17amm98/openflight/cad/IARC_case/README.md

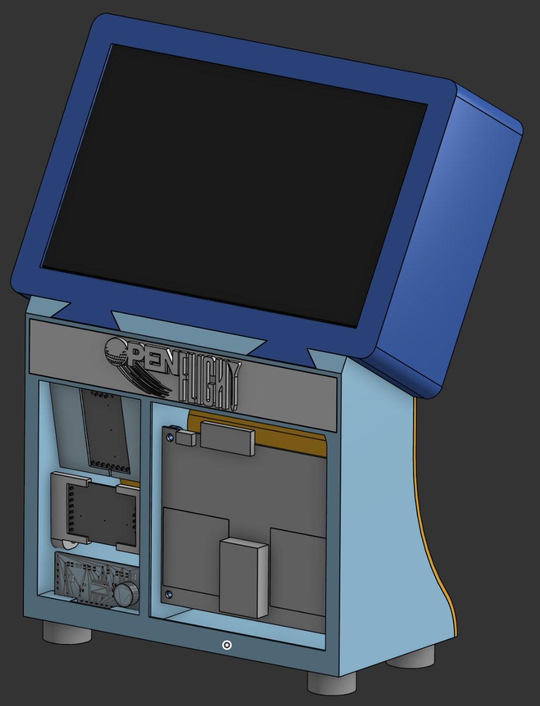
[picture p1: cad/IARC_case/images/IARC_case_v3.png]


- M5 Bolts needed: 10
- M2.5 Bolts needed: 12

Instructions for OpenFlight IARC v3 Case Build
  
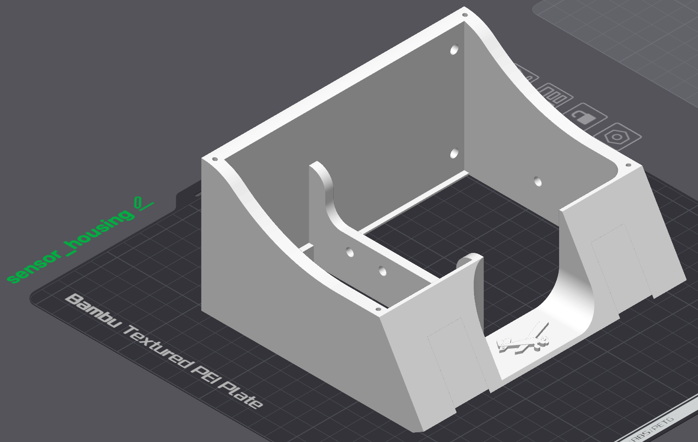
[picture p2: cad/IARC_case/images/sensor_housing.png]
1. Print out `sensor_housing.stl` 
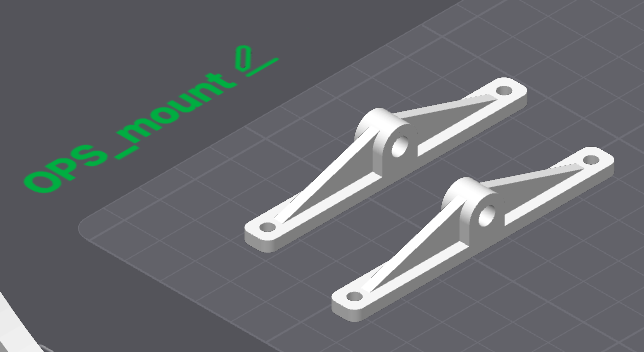
[picture p3: cad/IARC_case/images/ops_mount.png]
2. Print out (2x) `OPS_mount.stl` 
3. Secure the OPS sensor to each `OPS_mount.stl` part with screws (I don't know which ones)
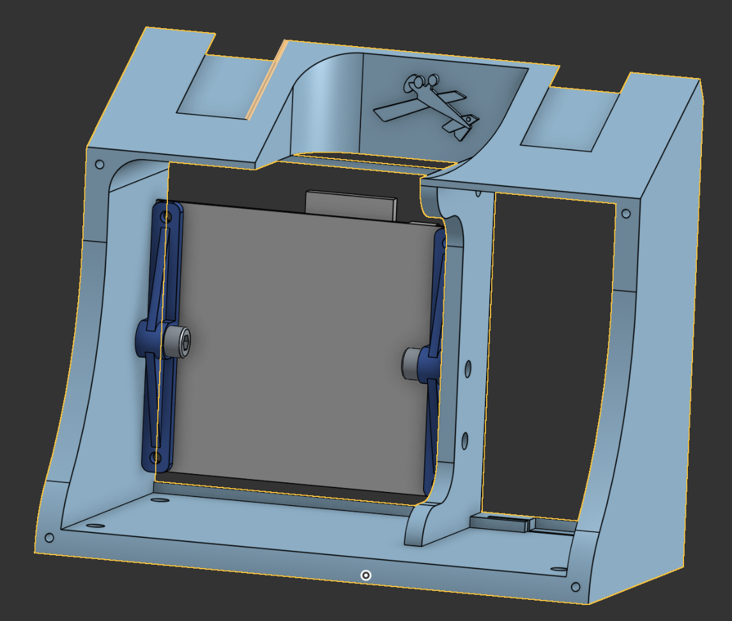
[picture p4: cad/IARC_case/images/secure_ops_mount.png]
4. Secure the `OPS_mount.stl` parts to the `sensor_housing.stl` part with (2x) M5 bolt 
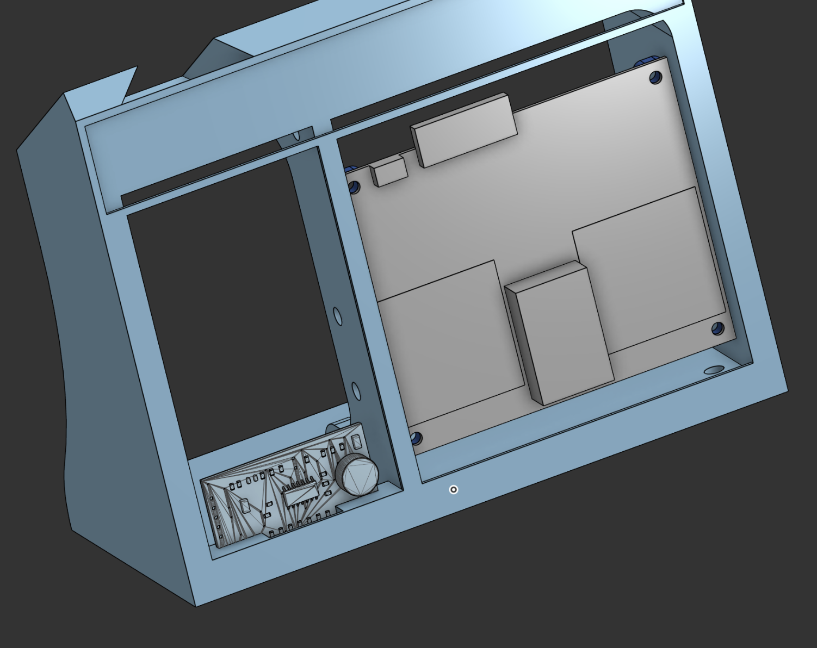
[picture p5: cad/IARC_case/images/sound_placement.png]
5. Fit the sound sensor into the little slot on the left side of the `sensor_housing.stl` part. 
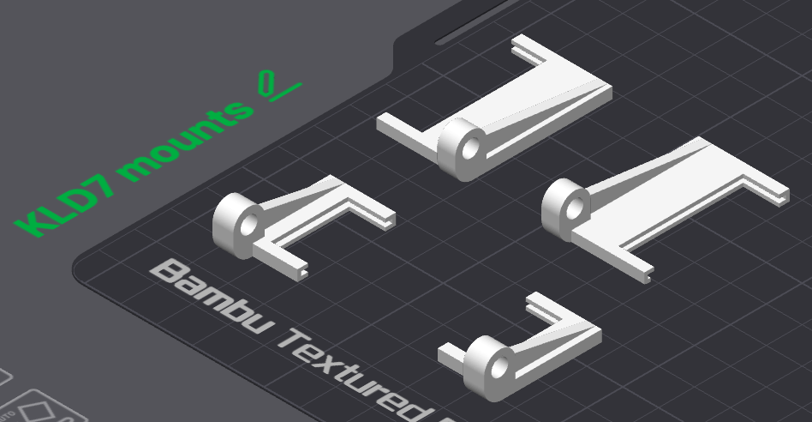
[picture p6: cad/IARC_case/images/KLD7_mounts.png]
6. Print out (1x) `KLD7_h_mount_L_v2.stl` and (1x) `KLD7_h_mount_R_v2.stl` 
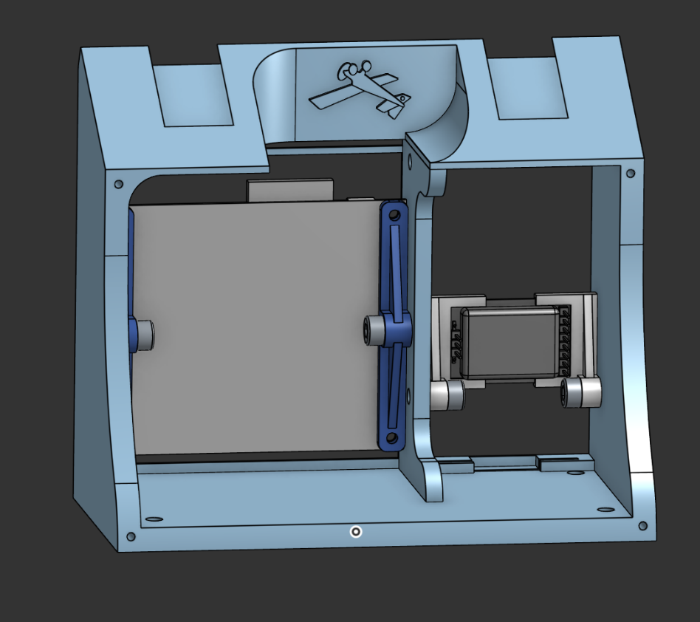
[picture p7: cad/IARC_case/images/bottom_KLD7_mount.png]
7. Slot a KLD7 sensor between the mount parts, and secure them to the `sensor_housing.stl` part with (2x) M5 bolt 
8. Print out (1x) `KLD7_v_mount_L_v2.stl` and (1x) `KLD7_v_mount_R_v2.stl` 
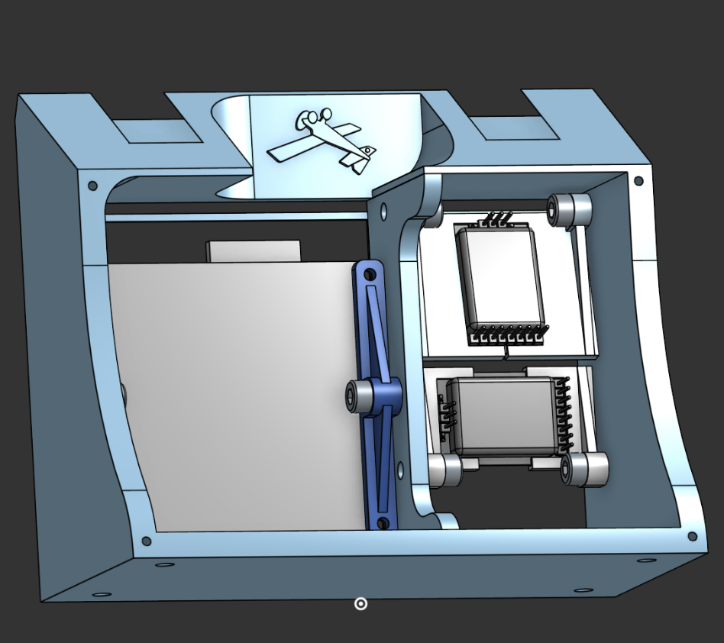
[picture p8: cad/IARC_case/images/top_KLD7_mount.png]
6. Slot a KLD7 sensor between the mount parts, and secure them to the `sensor_housing.stl` part with (2x) M5 bolt 
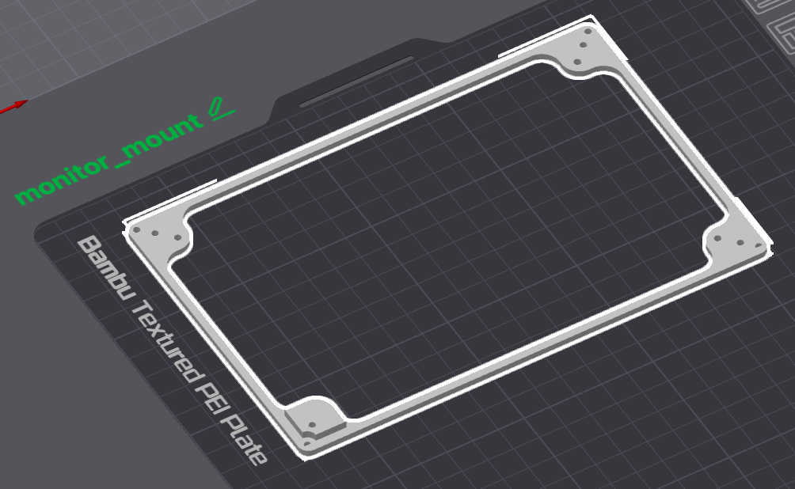
[picture p9: cad/IARC_case/images/monitor_mount_print.png]
7. Print out the `monitor_mount.stl` part. 
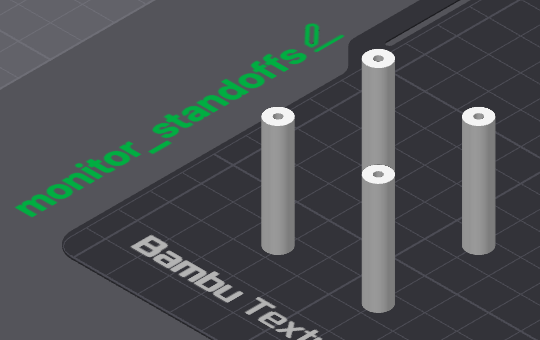
[picture p10: cad/IARC_case/images/monitor_standoffs_print.png]
8. Print out (4x) `monitor_standoffs.stl`'s. 
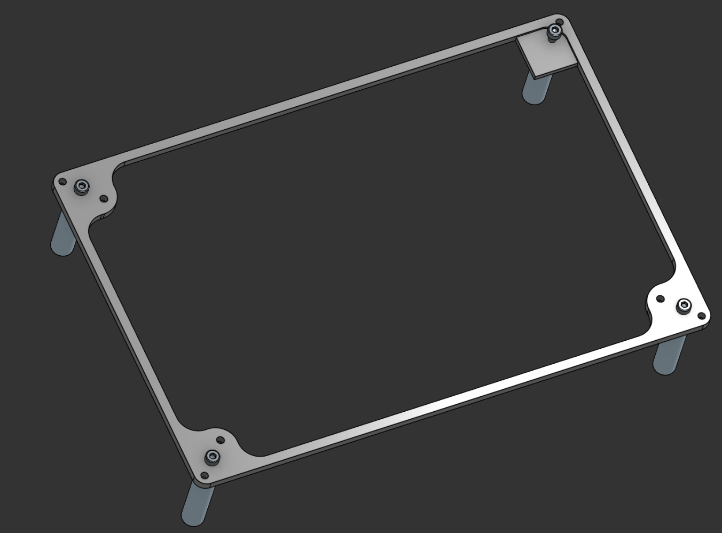
[picture p11: cad/IARC_case/images/monitor_mount_corners.png]
9. Secure each `monitor_standoff.stl` part to the corners of the `monitor_mount.stl` part with (1x) M2.5 bolt. 
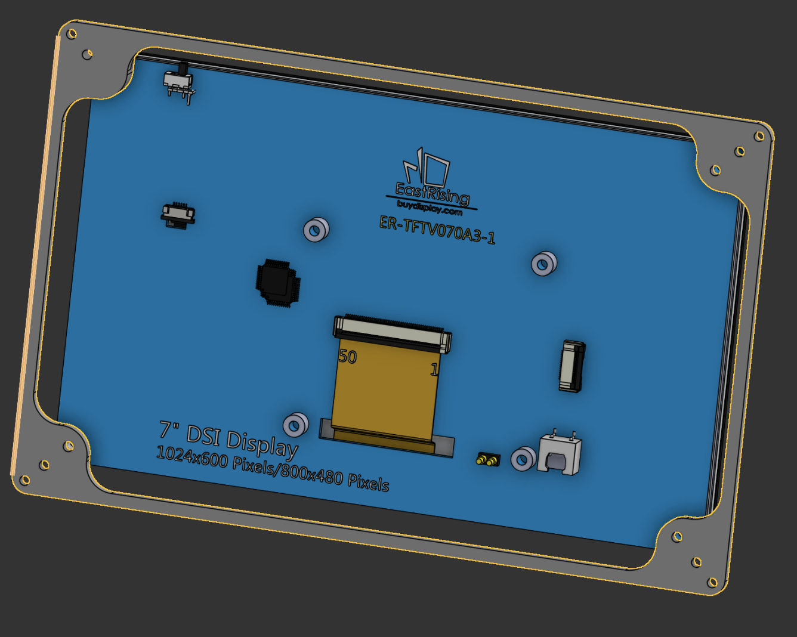
[picture p12: cad/IARC_case/images/monitor_secure.png]
10. Secure the monitor to the `monitor_mount.stl` part. 
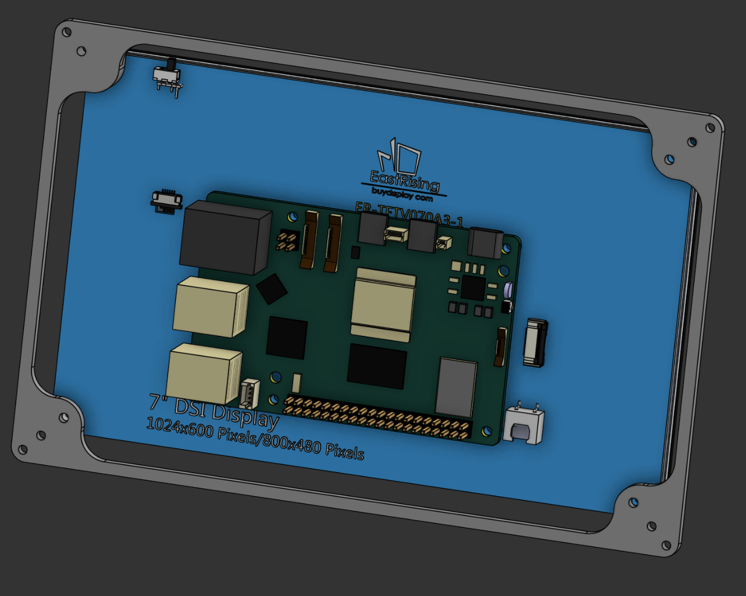
[picture p13: cad/IARC_case/images/rasp_secure.png]
11. Secure the raspberry Pi to the monitor. 
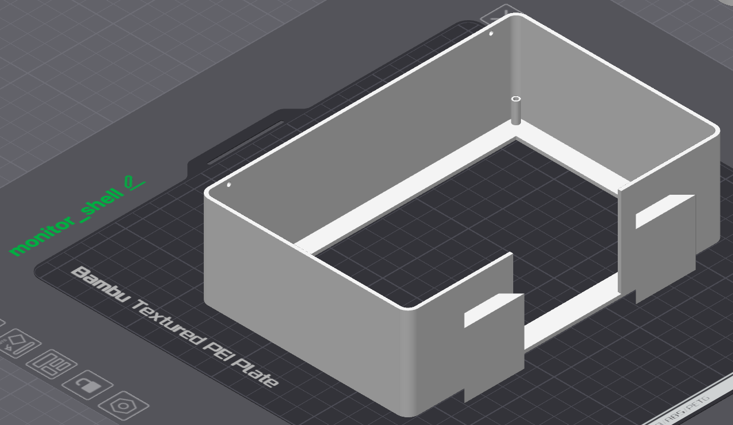
[picture p14: cad/IARC_case/images/monitor_shell_print.png]
12. Print out the `monitor_shell.stl` part. 
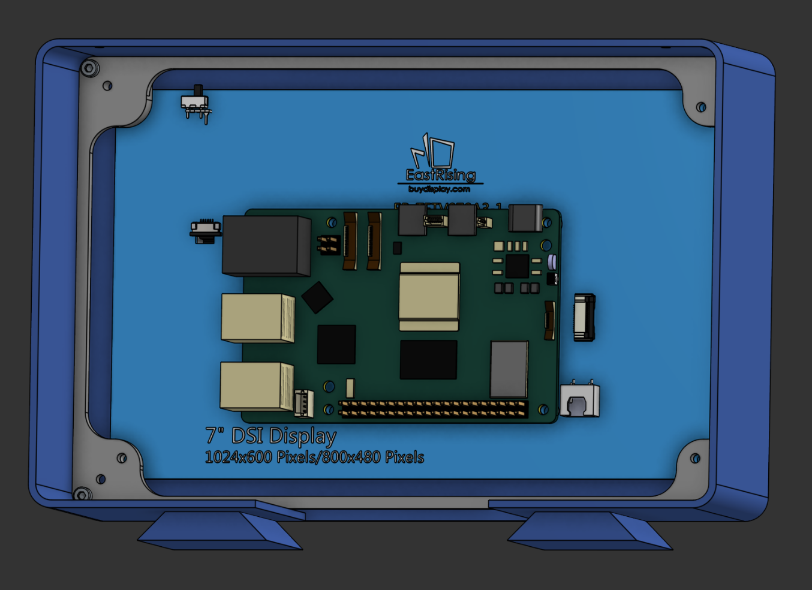
[picture p15: cad/IARC_case/images/monitor_shell_assembly.png]
13. Secure the monitor assembly inside the `monitor_shell.stl` part with (4x) M2.5 bolts at the corners. 
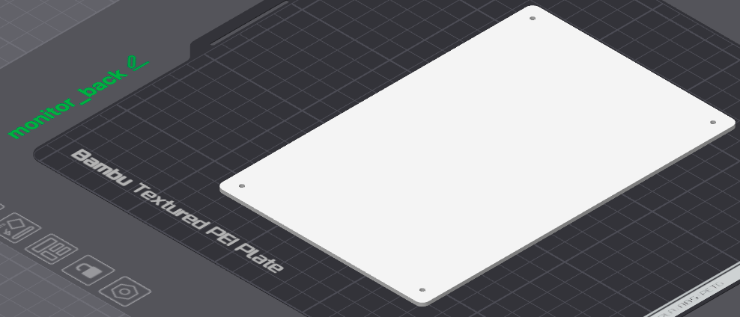
[picture p16: cad/IARC_case/images/monitor_back.png]
14. Print out the `monitor_back.stl` part. 
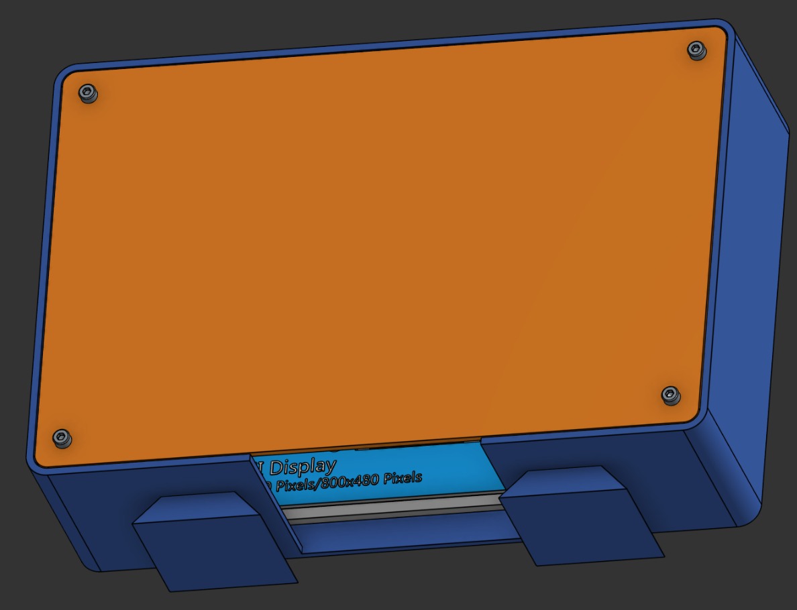
[picture p17: cad/IARC_case/images/monitor_back_secure.png]
15. Secure the `monitor_back.stl` part to the `monitor_standoffs.stl` parts with (4x) M2.5 bolts. 
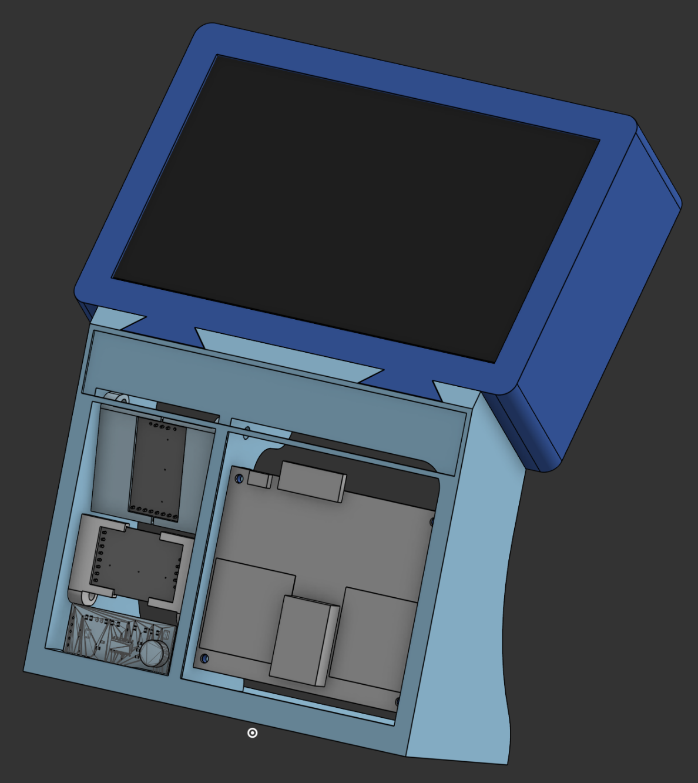
[picture p18: cad/IARC_case/images/whole_assembly.png]
16. Slide the whole assembly into the sensor housing assembly, using the dovetails to align everything together. 
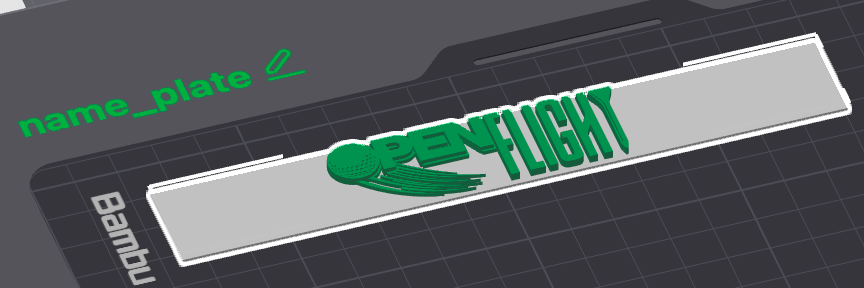
[picture p19: cad/IARC_case/images/name_plate_print.png]
17. Print out the `name_plate.stl` file. 
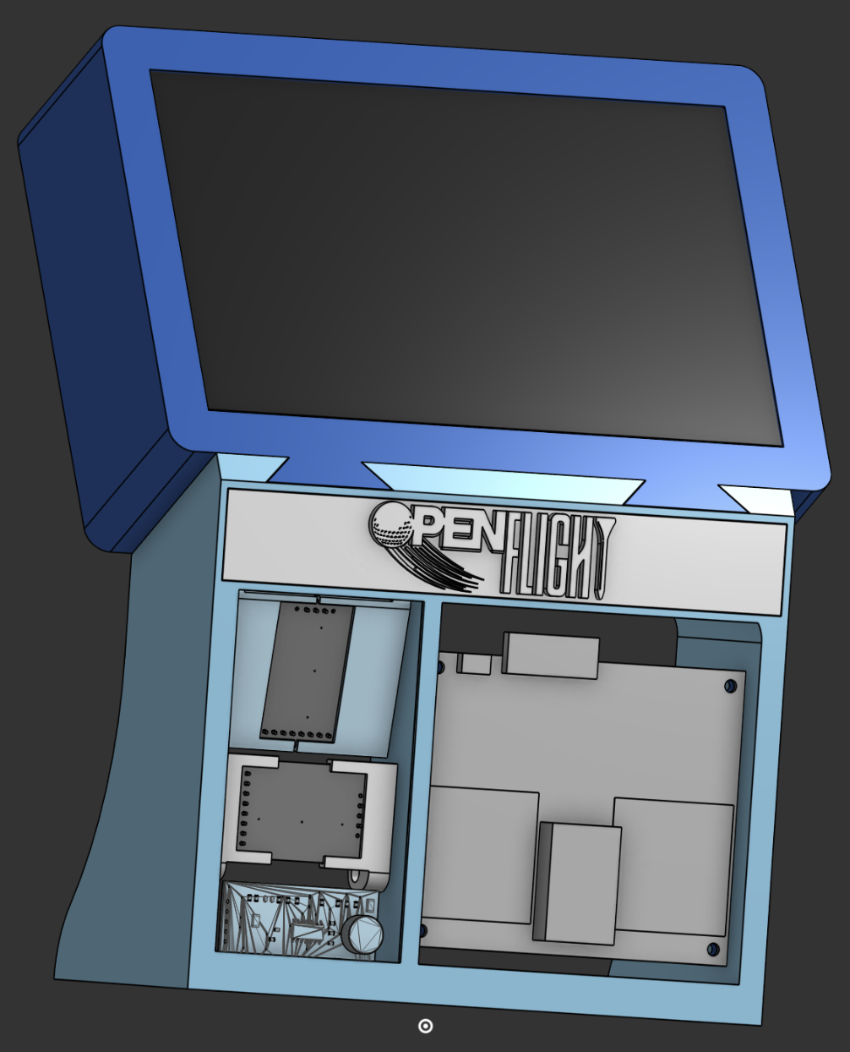
[picture p20: cad/IARC_case/images/name_plate_glue.png]
18. Secure the `name_plate.stl` file to the front of the whole assembly with glue. 
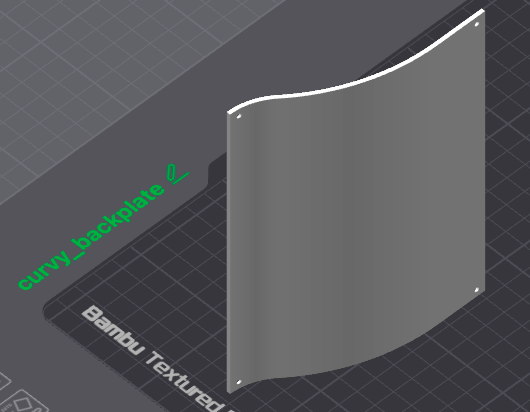
[picture p21: cad/IARC_case/images/curvy_backplate_print.png]
19. Print out the `curvy_backplate.stl` file. 
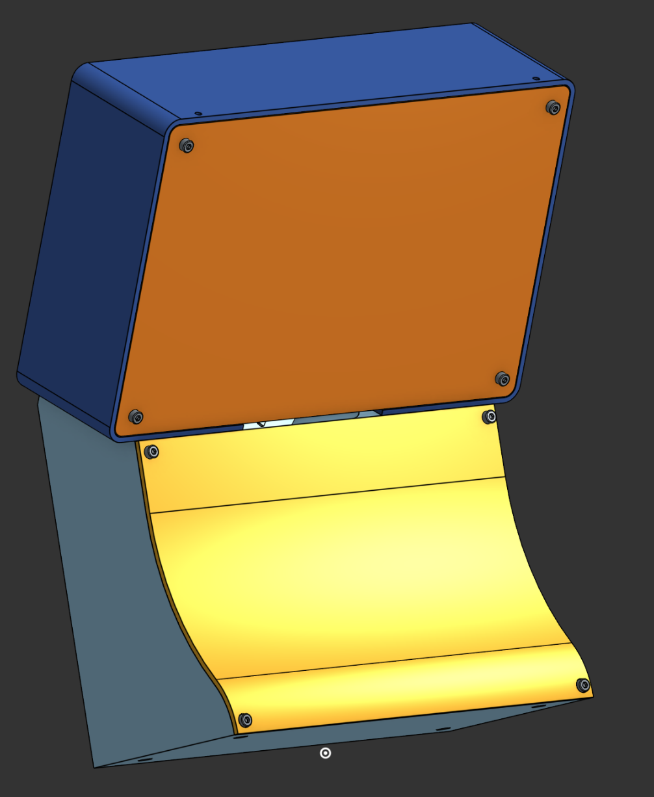
[picture p22: cad/IARC_case/images/curvy_backplate_secure.png]
20. Secure the `curvy_backplate.stl` file to the whole assembly with (4x) M2.5 bolts. 
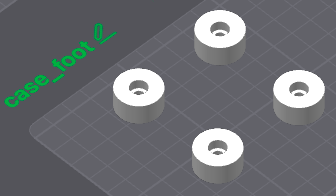
[picture p23: cad/IARC_case/images/case_foot_print.png]
21. Print out (4x) `case_foot.stl` parts. 
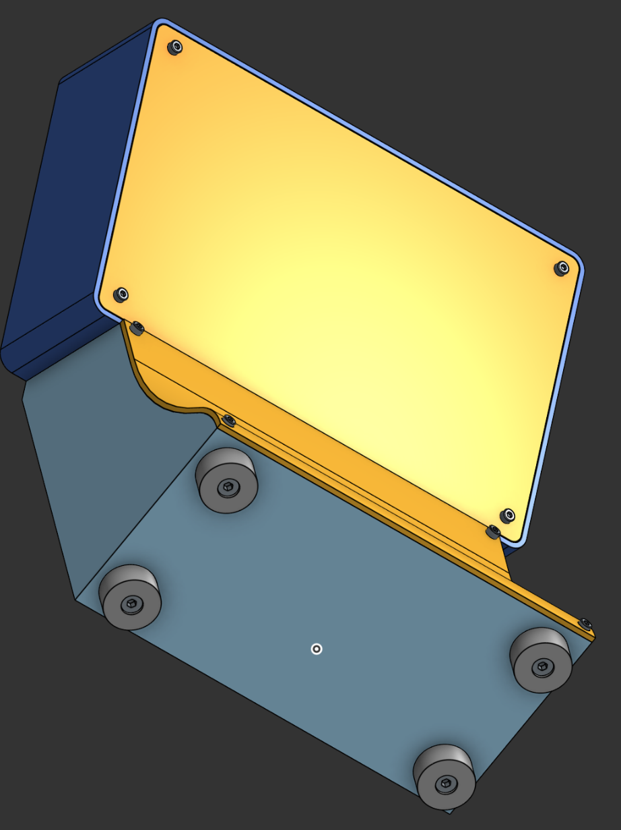
[picture p24: cad/IARC_case/images/feet_attach.png]
22. Secure each foot to the bottom of the whole assembly with (4x) M5 Bolts. 

And that’s how you put together the 3d printed parts!
