17amm98/openflight/docs/PARTS.md

# OpenFlight Parts List

Hardware components for building the OpenFlight golf launch monitor.

> **Next step after gathering parts:** See the [Raspberry Pi Setup Guide](raspberry-pi-setup.md) for assembly and software installation.

## Core Components

| Part | Description | Link | ~Price |
|---|---|---|---|
| **OPS243-A Radar** | Doppler radar for ball/club speed detection | [OmniPreSense](https://omnipresense.com/product/ops243-a-doppler-radar-sensor/) | $249 |
| **Raspberry Pi 5** | Main compute unit (4GB+ recommended) | [Adafruit](https://www.adafruit.com/product/5812) | $60 |
| **7" Touchscreen Display** | HMTECH 7" 1024x600 IPS display | [Amazon](https://www.amazon.com/dp/B0D3QB7X4Z) | $46 |

## Sound Trigger (for Rolling Buffer Mode)

The sound trigger detects club impact to precisely time radar captures. Essential for spin detection via rolling buffer mode.

| Part | Description | Link | ~Price |
|---|---|---|---|
| **SparkFun SEN-14262** | Sound Detector with envelope/gate outputs | [SparkFun](https://www.sparkfun.com/products/14262) | $12 |
| **Through-hole resistor** | For R17 pad on SEN-14262 to reduce sensitivity (see note) | Any electronics supplier | $1 |
| **Jumper Wires** | 3 wires: GATE → HOST_INT, VCC → 3.3V, GND → GND | Any | $5 |

> **R17 resistor:** The SEN-14262 is rated for 5V but runs at 3.3V in this setup, which can cause the GATE output to stick high. Soldering a resistor into the R17 through-hole position (in parallel with the onboard 100kΩ R3) reduces preamp gain and fixes this. Start with 47kΩ; use a lower value (e.g. 33kΩ) if the sensor is still too sensitive for your environment.

### Sound Trigger Wiring

```
SEN-14262               Raspberry Pi           OPS243-A
┌───────────┐          ┌──────────┐          ┌──────────┐
│ VCC ──────┼──────────┤ 3.3V     │          │          │
│           │          │          │          │          │
│ GATE ─────┼──────────┼──────────┼──────────┤ HOST_INT │
│           │          │          │          │ (J3 P3)  │
│ GND ──────┼──────────┤ GND      ├──────────┤ GND      │
│           │          │          │          │ (J3 P1)  │
└───────────┘          └──────────┘          └──────────┘
```

See [sound-trigger-wiring.md](sound-trigger-wiring.md) for detailed instructions and troubleshooting.

## Angle Radar (K-LD7)

Two K-LD7 modules measure launch angle (vertical) and club path / aim direction (horizontal). The OPS243-A handles speed; the K-LD7s provide **angle and distance only** (speed data aliases above 62 mph).

| Part | Description | Link | ~Price |
|---|---|---|---|
| **RFbeam K-LD7 (×2)** | 24 GHz FMCW radar for angle + distance | [RFbeam](https://rfbeam.ch/product/k-ld7-radar-transceiver/) | ~$60 ea |
| **FTDI USB-to-Serial adapter (×2)** | 3.3V FTDI board for K-LD7 UART (e.g. FT232RL) | [Amazon](https://www.amazon.com/s?k=ftdi+3.3v+usb+serial) | ~$10 |

> **EVAL board not required.** The K-LD7 bare module communicates over 3.3V UART (TX, RX, VCC, GND). Any 3.3V FTDI USB-to-serial adapter works. The official K-LD7 EVAL board (~$120 each) is only needed if you want the RFbeam GUI software for configuration — OpenFlight configures the radar over serial automatically.

### K-LD7 Connection

Each K-LD7 connects via a 3.3V FTDI adapter, appearing as `/dev/ttyUSB*` on Linux.

```
K-LD7 Module (UART) → FTDI 3.3V Adapter → USB → Raspberry Pi
```

One unit is mounted vertically (launch angle), one horizontally (club path / aim direction). A `--kld7-angle-offset` parameter corrects for mounting geometry — see the [setup guide](raspberry-pi-setup.md) for calibration.

## Power & Accessories

| Part | Description | Link | ~Price |
|---|---|---|---|
| **27W USB-C Power Supply** | Official Pi 5 power supply (5V 5A) | [Adafruit](https://www.adafruit.com/product/5974) | $12 |
| MicroSD Card (32GB+) | For Pi OS and software | Any Class 10 | $10 |
| USB-A to Micro-USB Cable | For OPS243-A radar connection | Any | $5 |

## Optional

| Part | Description | Link | ~Price |
|---|---|---|---|
| Tripod Mount | For positioning the unit | 1/4"-20 mount | $10 |

---

## Cost Summary

| Category | ~Price |
|---|---|
| Core (OPS243-A, Pi 5, Display) | $355 |
| Sound Trigger (SEN-14262 + resistor + wires) | $18 |
| Angle Radar (2× K-LD7 + FTDI adapters) | $140 |
| Power & Accessories | $27 |
| **Total** | **~$540** |

> The angle radar is the most expensive component. OpenFlight works without it — you'll get ball speed, club speed, smash factor, and estimated carry. The K-LD7s add measured launch angle and club path data.
