17amm98/openflight/cad/logo/MainLogo.DXF

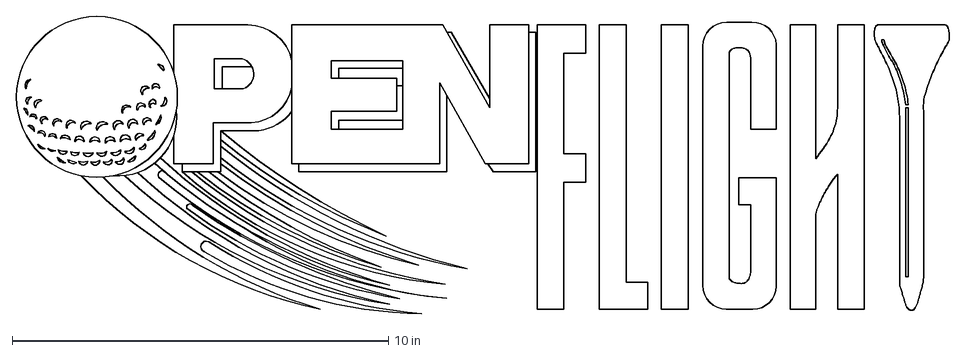
[picture p25: CAD file, 2026-04-09]
cad/logo/MainLogo.DXF
24.8 x 7.90 in
