17amm98/openflight/cad/17amm98 CASE/STEP/OpenFlight Enclosure.STEP

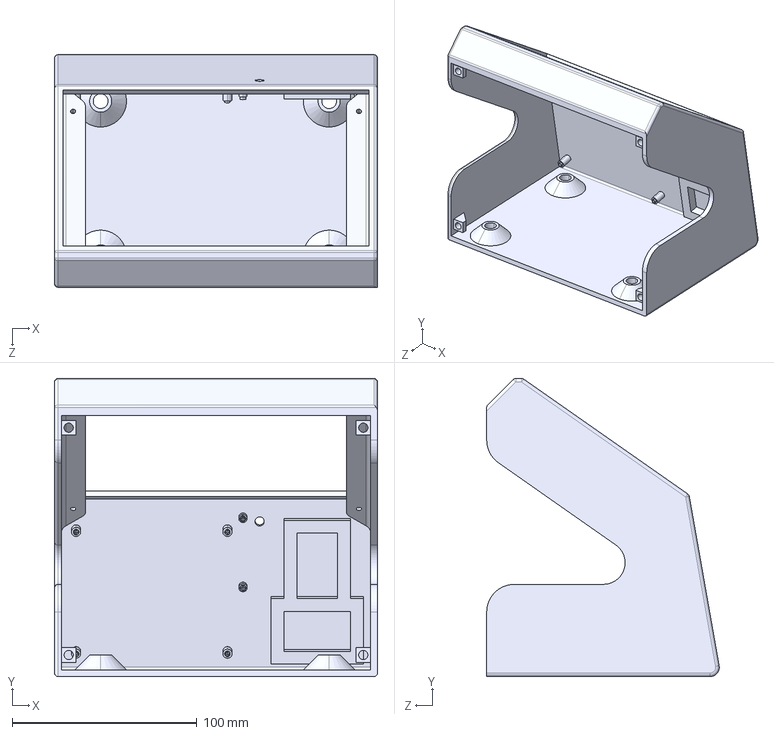
[picture p26: CAD file, 2026-04-09]
cad/17amm98 CASE/STEP/OpenFlight Enclosure.STEP
175.0 x 161.6 x 126.0 mm
