17amm98/openflight/cad/IARC_case/IARC_Case_v3.3mf

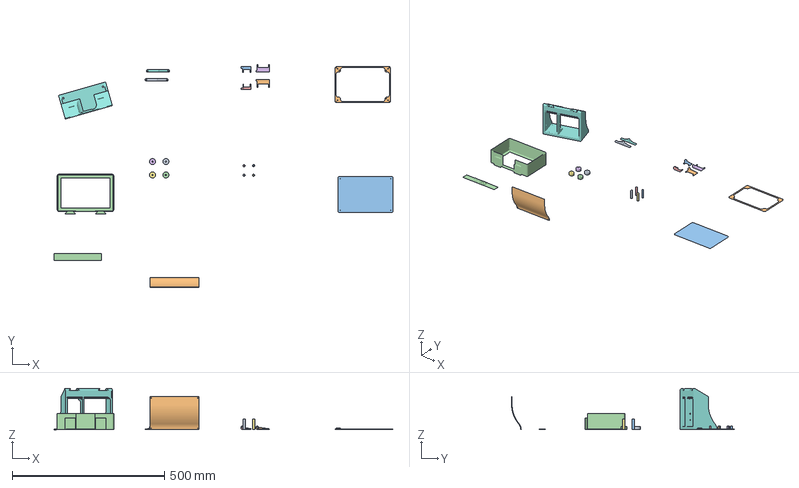
[picture p27: CAD file, 2026-04-09]
cad/IARC_case/IARC_Case_v3.3mf
1113.5 x 732.3 x 136.2 mm
case_foot.stl x 4
curvy_backplate.stl
monitor_standoffs.stl x 4
monitor_shell.stl
KLD7_v_mount_L_v2.stl
sensor_housing.stl
KLD7_v_mount_R_v2.stl
KLD7_h_mount_L_v2.stl
KLD7_h_mount_R_v2.stl
OPS_mount.stl x 2
monitor_mount.stl
monitor_back.stl
name_plate.stl
