17amm98/openflight/cad/IARC_case/step/sensor_housing.step

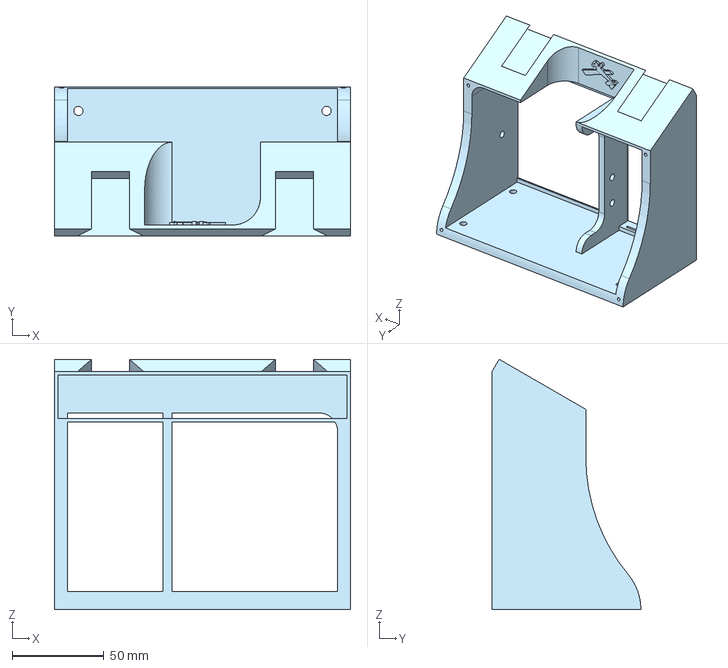
[picture p28: CAD file, 2026-04-09]
cad/IARC_case/step/sensor_housing.step
161.0 x 81.0 x 136.2 mm
