17amm98/openflight/cad/LordFarq/OpenFlight_LF.STEP

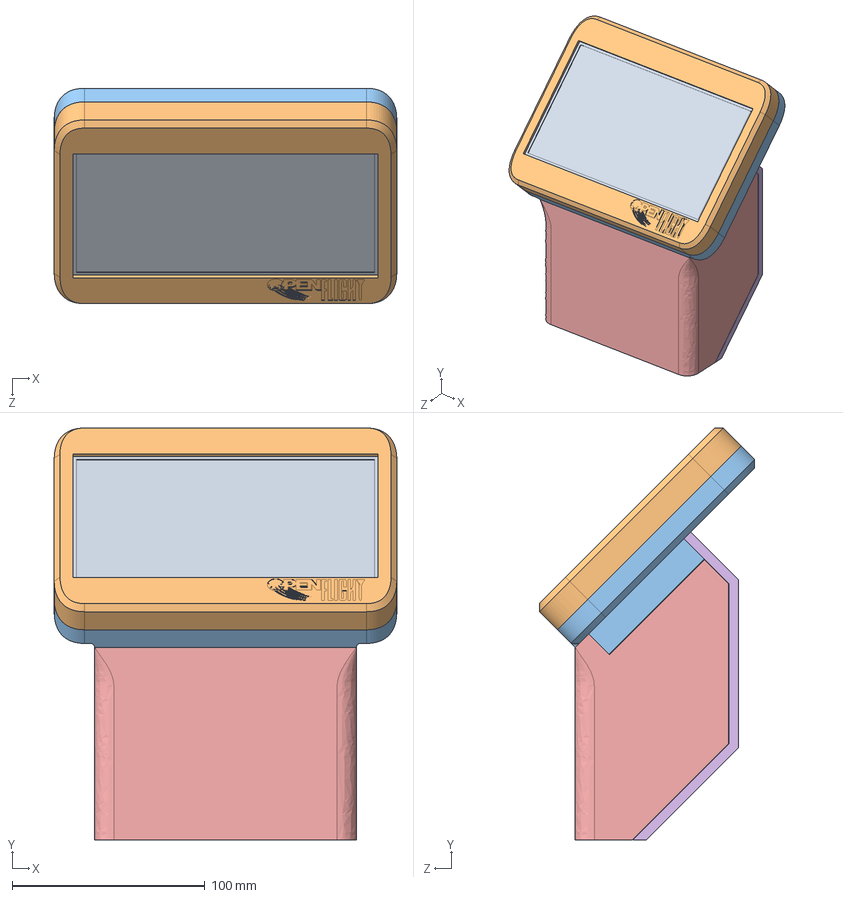
[picture p29: CAD file, 2026-04-09]
cad/LordFarq/OpenFlight_LF.STEP
178.0 x 214.0 x 111.9 mm
Screen
ScreenBezelFront
RearScreen
OPS243
BaseFront
BaseRear
