17amm98/openflight/cad/17amm98 CASE/STEP/OpenFlight Enclosure Backplate.STEP

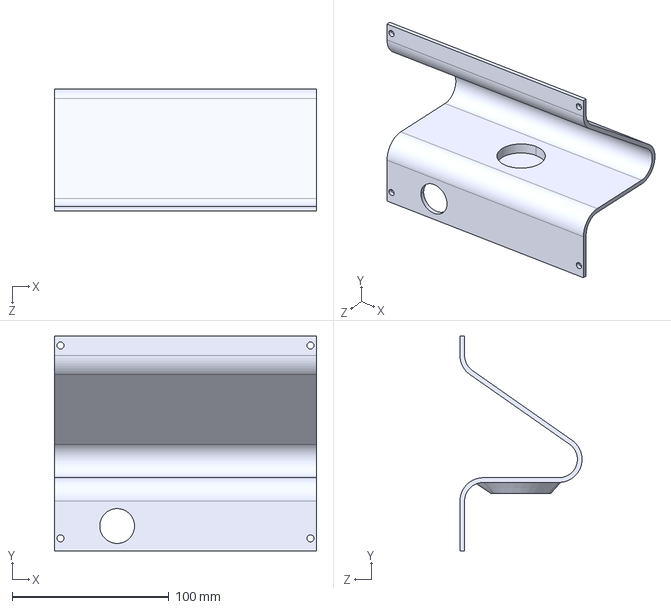
[picture p30: CAD file, 2026-04-09]
cad/17amm98 CASE/STEP/OpenFlight Enclosure Backplate.STEP
167.2 x 137.1 x 78.0 mm
