17amm98/openflight/cad/IARC_case/OPS_mount.stl

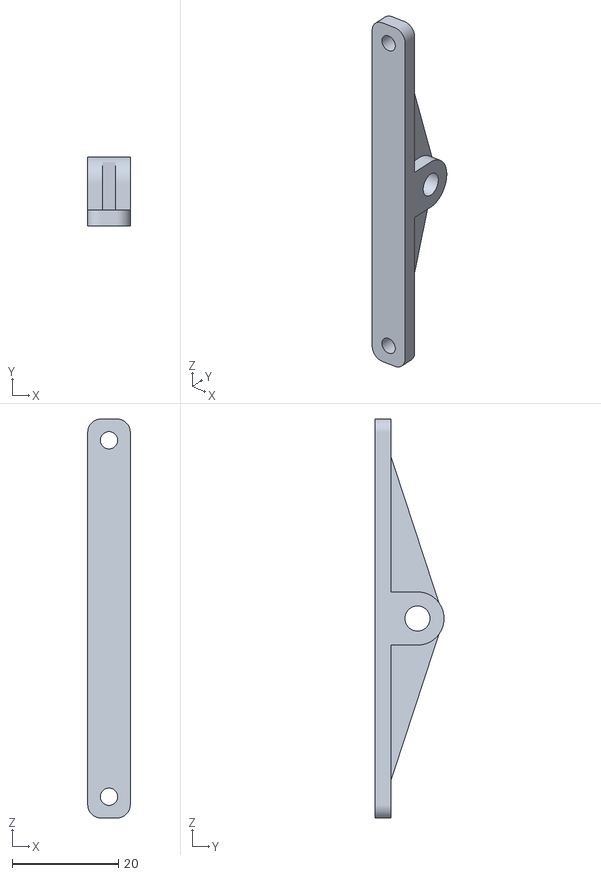
[picture p31: CAD file, 2026-04-02]
cad/IARC_case/OPS_mount.stl
8.00 x 13.0 x 75.0
