17amm98/openflight/cad/IARC_case/step/monitor_standoffs.step

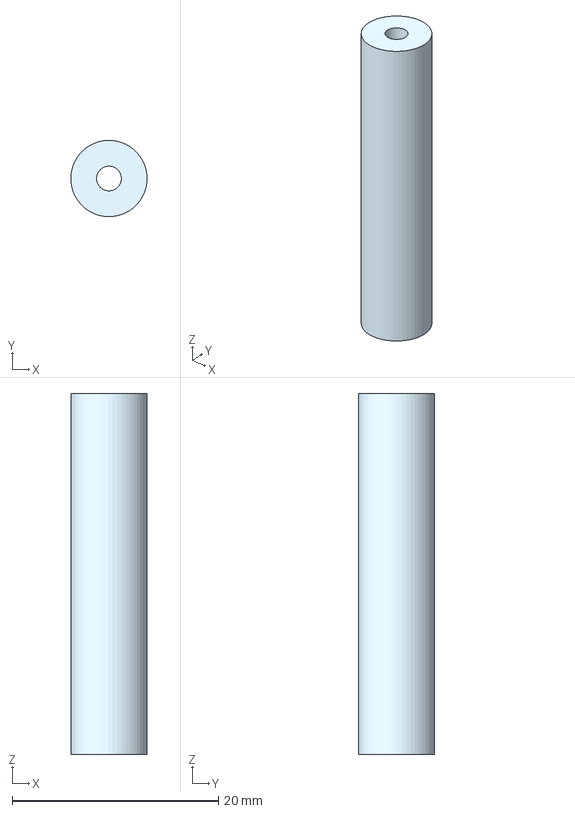
[picture p32: CAD file, 2026-04-09]
cad/IARC_case/step/monitor_standoffs.step
7.39 x 7.40 x 35.0 mm
