17amm98/openflight/cad/IARC_case/KLD7_h_mount_R.stl

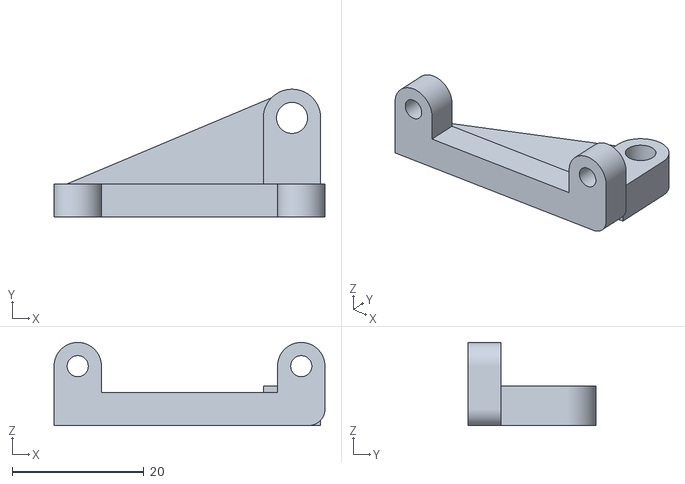
[picture p33: CAD file, 2026-04-02]
cad/IARC_case/KLD7_h_mount_R.stl
41.1 x 19.4 x 12.6
