17amm98/openflight/cad/IARC_case/step/monitor_shell.step

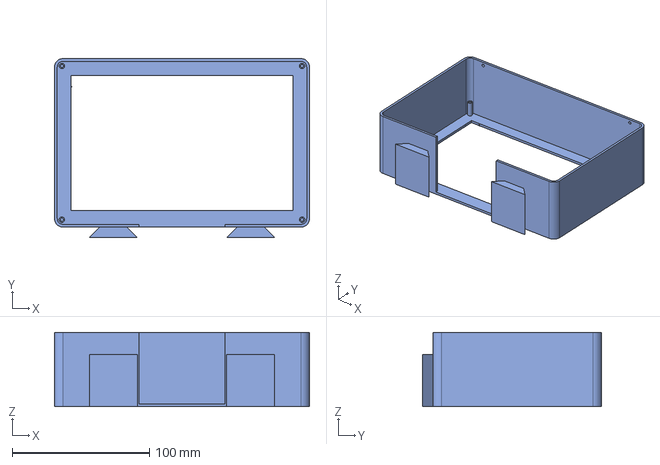
[picture p34: CAD file, 2026-04-09]
cad/IARC_case/step/monitor_shell.step
185.8 x 130.3 x 54.0 mm
