17amm98/openflight/cad/IARC_case/step/KLD7_v_mount_R_v2.step

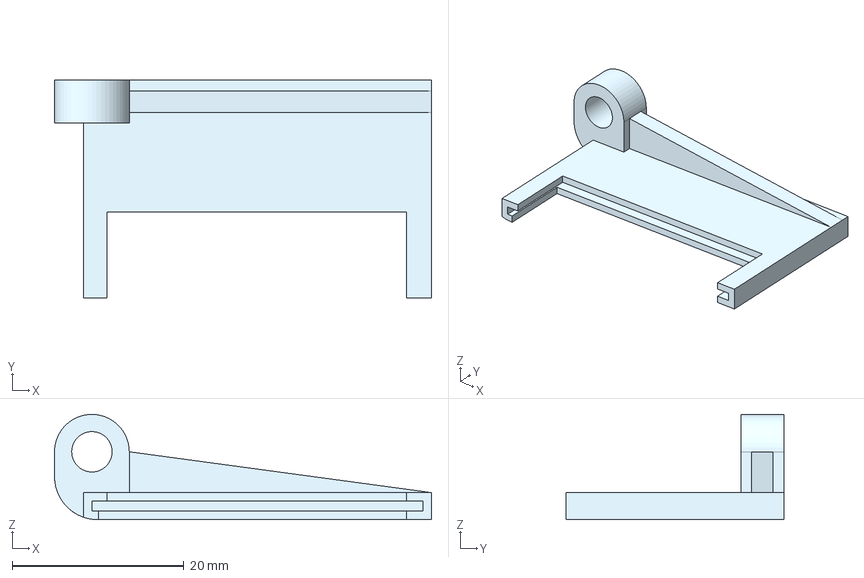
[picture p35: CAD file, 2026-04-09]
cad/IARC_case/step/KLD7_v_mount_R_v2.step
43.8 x 25.3 x 12.2 mm
