17amm98/openflight/cad/IARC_case/step/curvy_backplate.step

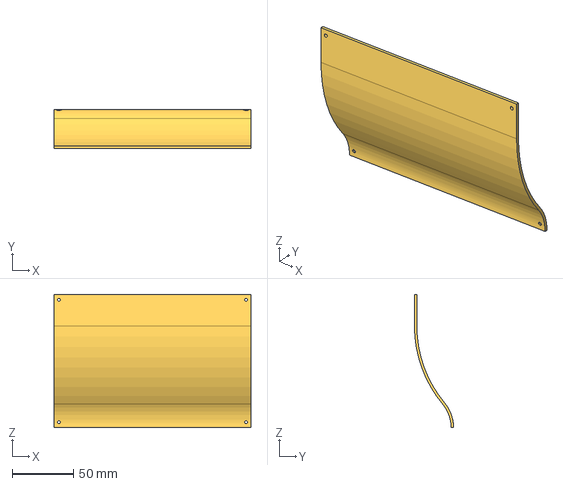
[picture p36: CAD file, 2026-04-09]
cad/IARC_case/step/curvy_backplate.step
161.0 x 32.0 x 109.0 mm
