17amm98/openflight/cad/IARC_case/step/monitor_back.step

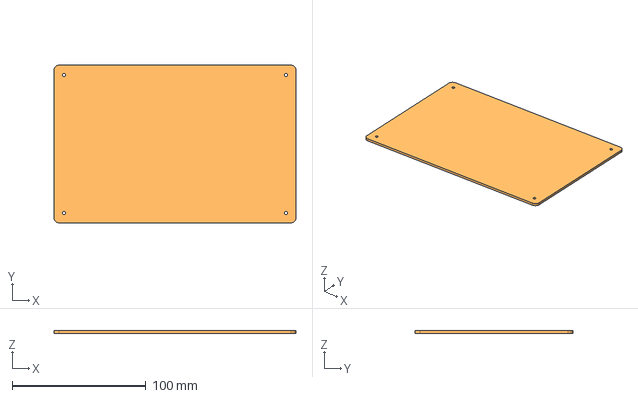
[picture p37: CAD file, 2026-04-09]
cad/IARC_case/step/monitor_back.step
181.0 x 118.0 x 2.00 mm
