17amm98/openflight/cad/IARC_case/step/monitor_mount.step

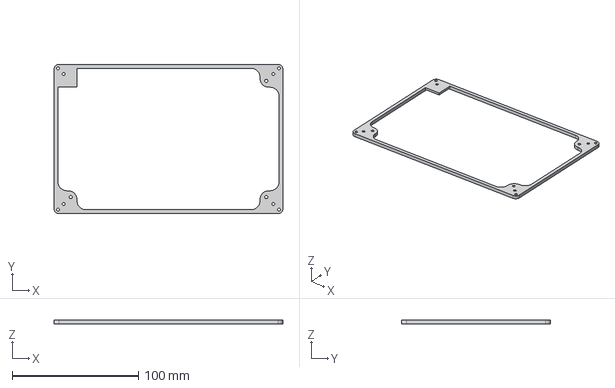
[picture p38: CAD file, 2026-04-09]
cad/IARC_case/step/monitor_mount.step
181.4 x 118.4 x 3.00 mm
