17amm98/openflight/cad/IARC_case/step/name_plate.step

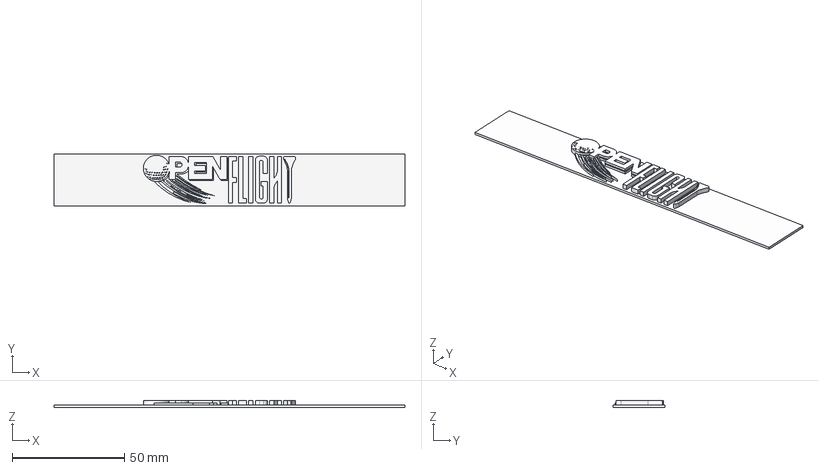
[picture p39: CAD file, 2026-04-09]
cad/IARC_case/step/name_plate.step
156.6 x 23.2 x 3.00 mm
