17amm98/openflight/(list of files, cad)

Other CAD files:
cad/IARC_case/step/KLD7_v_mount_L_v2.step
cad/IARC_case/step/KLD7_h_mount_L_v2.step
cad/17amm98 CASE/STL/OpenFlight Enclosure Backplate.STL
cad/17amm98 CASE/STL/OpenFlight Enclosure.STL
cad/IARC_case/stl/KLD7_h_mount_L_v2.stl
cad/IARC_case/stl/KLD7_h_mount_R_v2.stl
cad/IARC_case/stl/KLD7_v_mount_L_v2.stl
cad/IARC_case/stl/KLD7_v_mount_R_v2.stl
cad/IARC_case/stl/curvy_backplate.stl
cad/IARC_case/stl/monitor_back.stl
cad/IARC_case/stl/monitor_mount.stl
cad/IARC_case/stl/monitor_shell.stl
cad/IARC_case/stl/monitor_standoffs.stl
cad/IARC_case/stl/name_plate.stl
cad/IARC_case/stl/sensor_housing.stl
