17amm98/openflight/(commit log)

2026-03-01 [cr] fix launch angle test
    [test_launch_angle.py]
2026-03-02 [cr] estimate a launch angle if we dont get one from camera
2026-03-03 Add design doc for enhanced launch angle estimation
    Uses smash factor and spin rate to improve launch angle estimates
    beyond the current club-type-only lookup, and wires launch angle
    into carry distance calculation.
2026-03-04 feat: add launch angle carry adjustment function
    adjust_carry_for_launch_angle() penalizes carry distance when
    launch angle deviates from optimal: -2.0 yards/deg too low,
    -1.5 yards/deg too high, scaled by confidence, capped at 10%.
    [launch_monitor.py]
2026-03-10 [cr] fix capture window
    [capture_iq.py]
2026-03-29 test(kld7): add integration tests for K-LD7 angle data flow
2026-04-02 experiment(kld7): add noise filtering tests — reject body movement, accept ball events
    [test_kld7.py]
2026-04-02 experiment(kld7): add speed/angle/duration filters with updated test speeds
2026-04-02 experiment(kld7): add edge case tests — TDAT-only, multi-speed PDAT, high confidence
2026-04-02 experiment(kld7): tighten false positive threshold, add quiet period real data test
    [test_kld7.py]
2026-04-02 feat(kld7): classify detections as ball vs club, add get_club_angle()
    - KLD7Angle.detection_class: "ball" (angle >= 0) or "club" (angle < 0)
    - get_angle_for_shot() prefers ball events, falls back to club
    - get_club_angle() extracts club angle of attack separately
    - Shot.club_angle_deg field + shot_to_dict support
    - Server passes both ball and club angle to shot data
    - test_kld7.py captures --club, --shots, --notes metadata
    - Known limitation: sign-based classification won't work for driver AoA
    [launch_monitor.py, server.py, test_kld7.py, tracker.py, types.py]
2026-04-02 feat(kld7): log raw K-LD7 buffer alongside OPS shots for correlation analysis
    - KLD7Tracker.snapshot_buffer() captures ring buffer before processing
    - SessionLogger.log_kld7_buffer() writes raw frames + processed angles
    - on_shot_detected() snapshots buffer before angle extraction
    - Each shot now has both OPS speed data and K-LD7 angle frames in session log
2026-04-06 [cr] run both radars for testing kld7 ADC
2026-04-06 feat: stream RADC at 3Mbaud for phase-interferometry data
    [tracker.py]
2026-04-08 [cr] make sure serial buffer is empty before re-arm
2026-04-08 [cr] specify eval board not required
2026-04-09 Create 17amm98 CASE
